ConnectedHumber/Air-Quality-Kit/README.md

# Air-Quality-Kit
Open source documentation and firmware for the CH HumberLora Kit

## Heltec Sensor V2

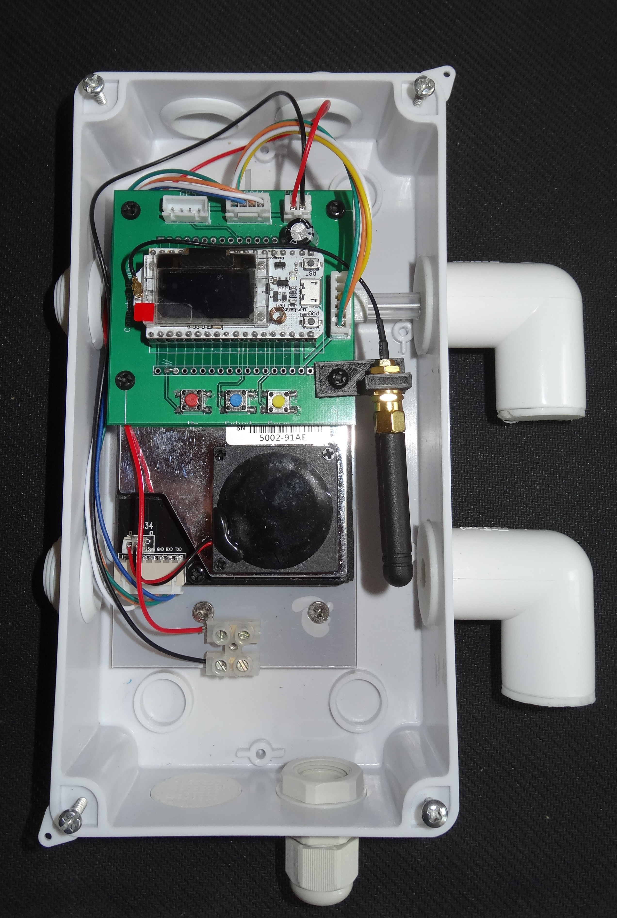
[picture p1: Images/Heltec Sensor V2.jpg]
