ConnectedHumber/Air-Quality-Kit/Documentation/README.md

# Documentation

Documentation explaining the technical details of the CH HumberLora Kit and how to assemble the parts.
