ConnectedHumber/Air-Quality-Kit/PCB Designs/Firebeetle/KiCad/README.md

# Kicad files for the Firebeetle pcb design
