ConnectedHumber/Air-Quality-Kit/Images/AQ_V3_PCB.png

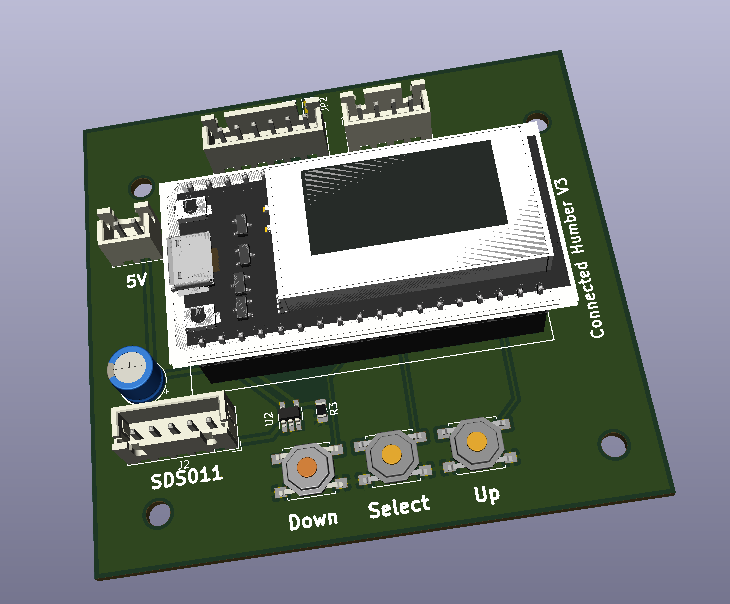
Images/AQ_V3_PCB.png
