ConnectedHumber/Air-Quality-Kit/3D_Parts/Mounting Plate.stl

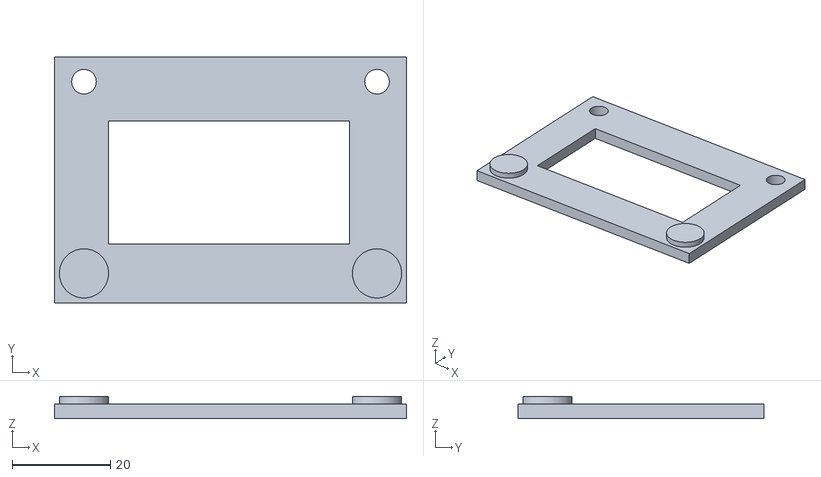
[picture p27: CAD file, 2019-08-29]
3D_Parts/Mounting Plate.stl
71.6 x 50.0 x 4.50
