ConnectedHumber/Air-Quality-Kit/3D_Parts/Drain with Mesh.stl

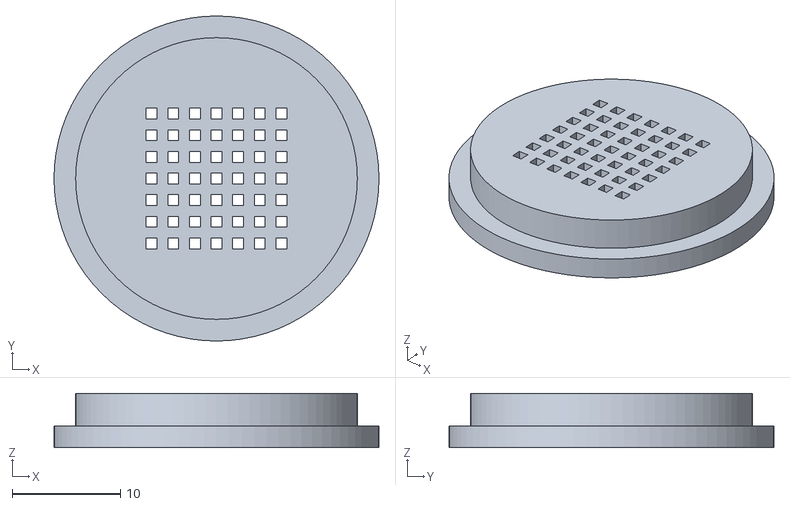
[picture p28: CAD file, 2019-08-27]
3D_Parts/Drain with Mesh.stl
30.0 x 30.0 x 5.00
