ConnectedHumber/Air-Quality-Kit/3D_Parts/Outer Vent Plug with Mesh.stl

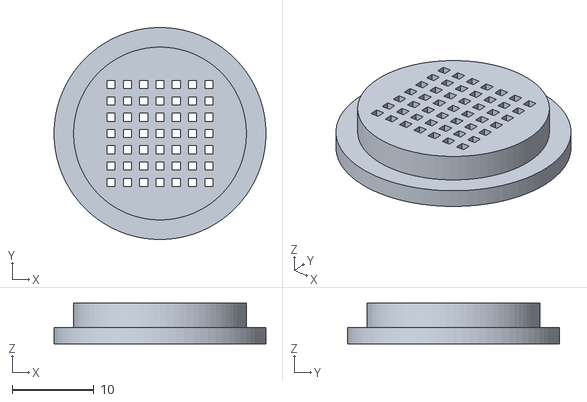
[picture p29: CAD file, 2019-08-27]
3D_Parts/Outer Vent Plug with Mesh.stl
26.0 x 26.0 x 5.00
