ConnectedHumber/Air-Quality-Kit/3D_Parts/Inner Vent Plug.stl

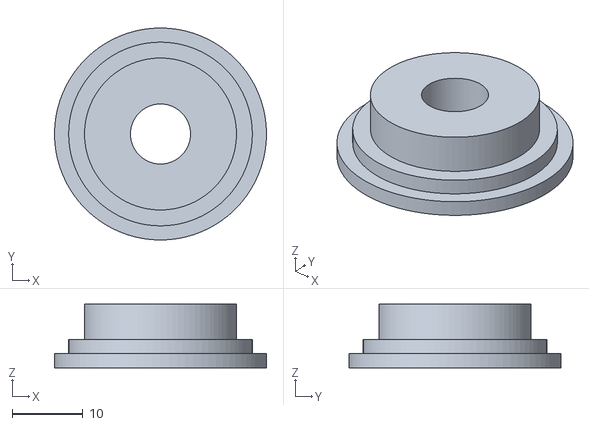
[picture p30: CAD file, 2019-08-25]
3D_Parts/Inner Vent Plug.stl
30.0 x 30.0 x 9.00
