ConnectedHumber/Air-Quality-Kit/3D_Parts/Drain.stl

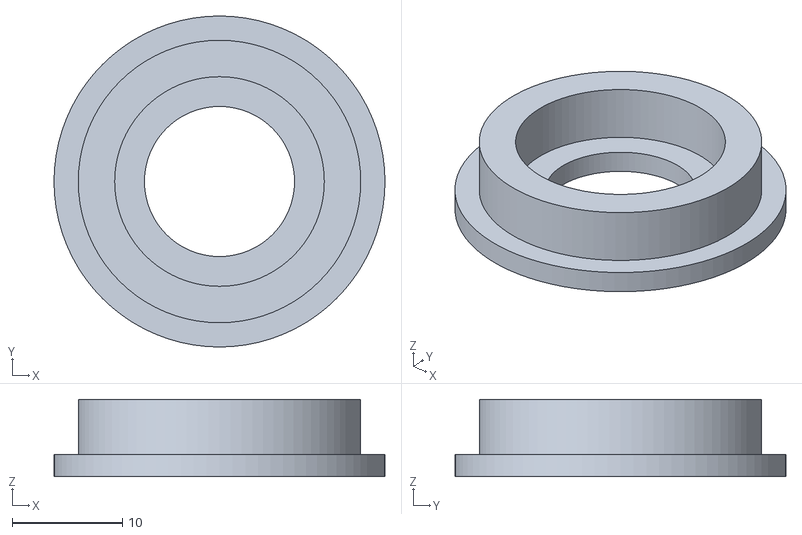
[picture p31: CAD file, 2019-08-25]
3D_Parts/Drain.stl
30.0 x 30.0 x 7.00
