ConnectedHumber/Air-Quality-Kit/3D_Parts/antennaMount.stl

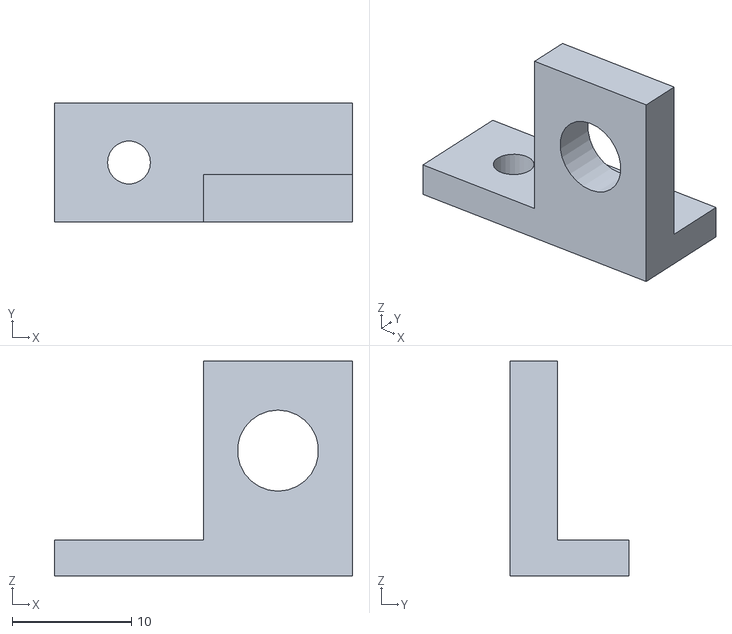
[picture p32: CAD file, 2019-08-25]
3D_Parts/antennaMount.stl
25.0 x 10.0 x 18.0
