ConnectedHumber/Air-Quality-Kit/3D_Parts/SensorLinkingPipe.stl

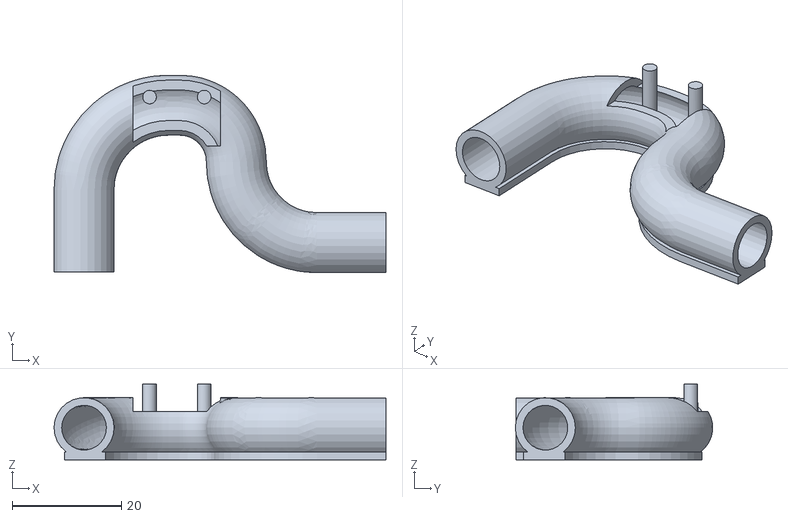
[picture p33: CAD file, 2019-08-25]
3D_Parts/SensorLinkingPipe.stl
60.8 x 36.1 x 13.9
