ConnectedHumber/Air-Quality-Kit/3D_Parts/Outer Vent Plug.stl

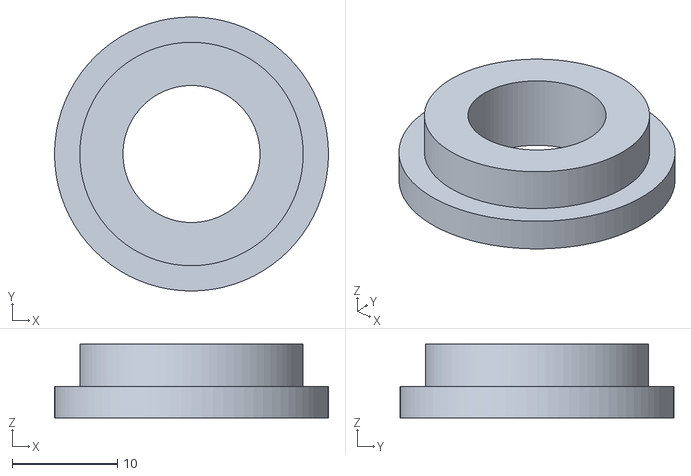
[picture p34: CAD file, 2019-08-25]
3D_Parts/Outer Vent Plug.stl
26.0 x 26.0 x 7.00
