ConnectedHumber/Air-Quality-Kit/3D_Parts/Cable Inlet.stl

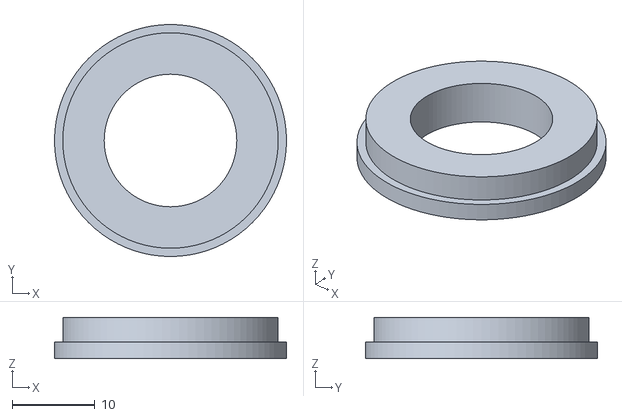
[picture p35: CAD file, 2019-08-25]
3D_Parts/Cable Inlet.stl
28.0 x 28.0 x 5.00
