ConnectedHumber/Air-Quality-Kit/PCB Designs/AQ_V3/Heltec.kicad_pcb

## KiCad design PCB Designs/AQ_V3/Heltec.kicad_pcb (2019-10-04)

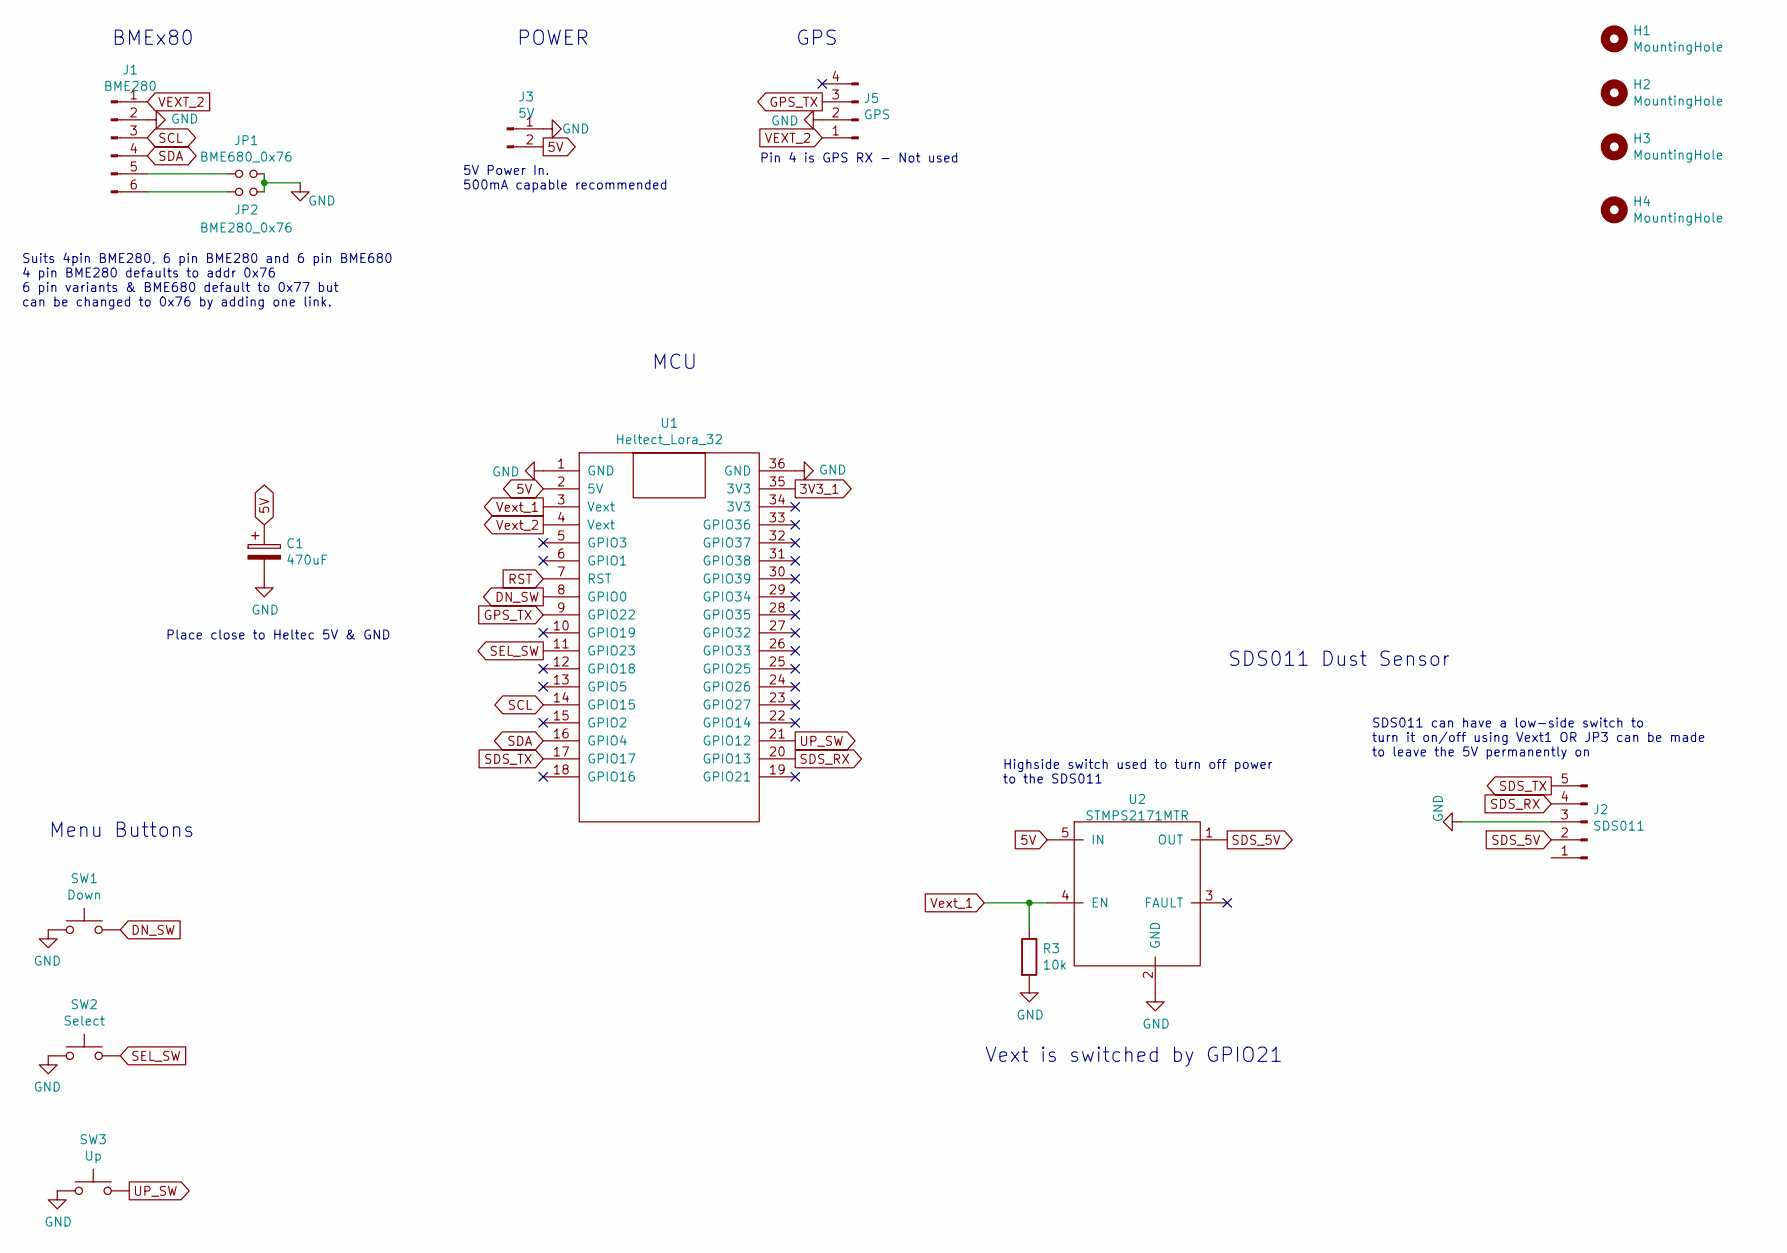
[picture p57: schematic Heltec.sch, Heltec Lora 32 Air Quality]

Parts:
C1: 470uF; CP_Radial_D6.3mm_P2.50mm
H1, H2, H3, H4: MountingHole; MountingHole_3.2mm_M3
J1: BME280; JST_XH_B06B-XH-A_1x06_P2.50mm_Vertical
J2: SDS011; JST_XH_B05B-XH-AM_1x05_P2.50mm_Vertical
J3: 5V; JST_XH_B02B-XH-A_1x02_P2.50mm_Vertical
J5: GPS; JST_XH_B04B-XH-A_1x04_P2.50mm_Vertical
JP1: BME680_0x76; SolderJumper-2_P1.3mm_Open_Pad1.0x1.5mm
JP2: BME280_0x76; SolderJumper-2_P1.3mm_Open_Pad1.0x1.5mm
R3: 10k; R_0805_2012Metric_Pad1.15x1.40mm_HandSolder
SW1: Down; SW_SPST_B3S-1000
SW2: Select; SW_SPST_B3S-1000
SW3: Up; SW_SPST_B3S-1000
U1: Heltect_Lora_32; Heltec_LoRa_32
U2: STMPS2171MTR; SOT-23-5_HandSoldering

Connections:
3V3_1: U1.35 (3V3)
5V: C1.1, J3.2, U1.2 (5V), U2.5 (IN)
DN_SW: SW1.1, U1.8 (GPIO0)
GND: C1.2, J1.2, J2.3, J3.1, J5.2, JP1.2, JP2.2, R3.2, SW1.2, SW2.1, SW3.1, U1.1 (GND), U1.36 (GND), U2.2 (GND)
GPS_TX: J5.3, U1.9 (GPIO22)
unnamed: J1.5, JP1.1
unnamed: J1.6, JP2.1
RST: U1.7 (RST)
SCL: J1.3, U1.14 (GPIO15)
SDA: J1.4, U1.16 (GPIO4)
SDS_5V: J2.2, U2.1 (OUT)
SDS_RX: J2.4, U1.20 (GPIO13)
SDS_TX: J2.5, U1.17 (GPIO17)
SEL_SW: SW2.2, U1.11 (GPIO23)
UP_SW: SW3.2, U1.21 (GPIO12)
VEXT_2: J1.1, J5.1
Vext_1: R3.1, U1.3 (Vext), U2.4 (EN)
Vext_2: U1.4 (Vext)

Notes on the sheet:
Place close to Heltec 5V & GND
Suits 4pin BME280, 6 pin BME280 and 6 pin BME680 4 pin BME280 defaults to addr 0x76 6 pin variants & BME680 default to 0x77 but can be changed to 0x76 by adding one link.
Pin 4 is GPS RX - Not used
SDS011 can have a low-side switch to turn it on/off using Vext1 OR JP3 can be made to leave the 5V permanently on
Highside switch used to turn off power to the SDS011
Menu Buttons
5V Power In. 500mA capable recommended
GPS
POWER
BMEx80
SDS011 Dust Sensor
MCU
Vext is switched by GPIO21

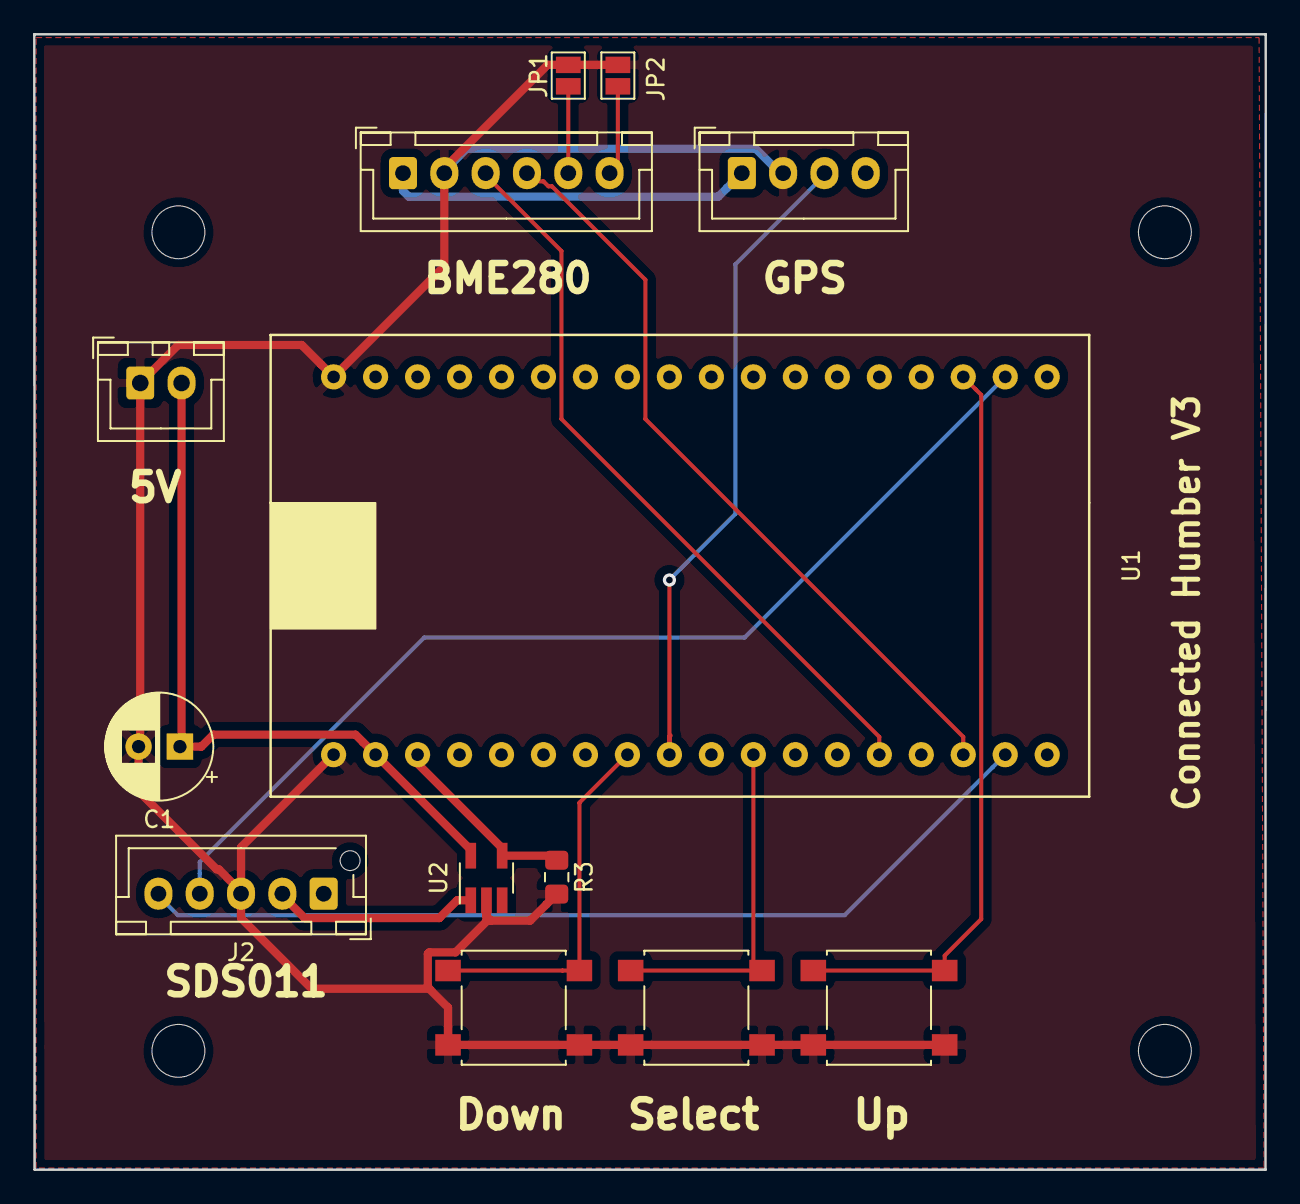
[picture p58: board Heltec.kicad_pcb from above]

Board: 2 copper layers, 74.5 x 68.7 mm, 17 parts (0 on the bottom side), 15 nets.
