ConnectedHumber/Air-Quality-Kit/Firmware/Sources/SensorReaderV3/lcd.cpp

// This example just provide basic function test;
// For more informations, please vist www.heltec.cn or mail to support@heltec.cn

#include "SSD1306.h" // alias for #include "SSD1306Wire.h"`

#include "OLEDDisplayUi.h"
#include "images.h"
#include "timing.h"
#include "settings.h"
#include "sensors.h"
#include "airquality.h"
#include "bme280.h"
#include "debug.h"
#include "lora.h"
#include "mqtt.h"
#include "processes.h"
#include "lcd.h"


//OLED pins to ESP32 GPIOs via this connecthin:
//OLED_SDA -- GPIO4
//OLED_SCL -- GPIO15
//OLED_RST -- GPIO16

struct LcdSettings lcdSettings;

boolean validateSplashScreen(void* dest, const char* newValueStr)
{
	return (validateString((char*)dest, newValueStr, SPLASH_LINE_LENGTH));
}

void setDefaultSplashTopLine(void* dest)
{
	Serial.println("setting default top line");
	snprintf((char*)dest, SPLASH_LINE_LENGTH, "Connected");
}

void setDefaultSplashBottomLine(void* dest)
{
	snprintf((char*)dest, SPLASH_LINE_LENGTH, "Humber");
}

struct SettingItem splash_screen_top_lineSetting = {
"Splash screen top line", "splashTop", lcdSettings.splash_screen_top_line, SPLASH_LINE_LENGTH, text, setDefaultSplashTopLine, validateSplashScreen };

struct SettingItem splash_screen_bottom_lineSetting = {
"Splash screen bottom line", "splashBtm", lcdSettings.splash_screen_bottom_line, SPLASH_LINE_LENGTH, text, setDefaultSplashBottomLine, validateSplashScreen };

struct SettingItem* lcdSettingItemPointers[] =
{
&splash_screen_bottom_lineSetting,
&splash_screen_top_lineSetting };

struct SettingItemCollection lcdSettingItems = {
	"lcd",
	"LCD settings for top and bottom line of home screen",
	lcdSettingItemPointers,
	sizeof(lcdSettingItemPointers) / sizeof(struct SettingItem*)
};


// later version of display constructor nominates a pin for reset which must be added to the
// constructor call

SSD1306 display(0x3c, 4, 15, 16);

OLEDDisplayUi ui(&display);

// from timing.h
unsigned long time_to_next_update();
bool updates_active();

void clockOverlay(OLEDDisplay *display, OLEDDisplayUiState *state)
{
    char time_buffer[100];

    display->setTextAlignment(TEXT_ALIGN_RIGHT);

    if (updates_active())
    {
        int time_to_update_secs = (int)(time_to_next_update() / 1000);

        switch (getTimingState())
        {
        case sensorOff:
            sprintf(time_buffer, "O %04d", time_to_update_secs);
            break;

        case sensorWarmingUp:
            sprintf(time_buffer, "W %04d", time_to_update_secs);
            break;

        case sensorGettingReading:
            sprintf(time_buffer, "R %04d", time_to_update_secs);
            break;
        }
    }

    display->setFont(ArialMT_Plain_10);
    display->drawString(128, 0, time_buffer);
}

void drawSplashScreen(OLEDDisplay *display, OLEDDisplayUiState *state, int16_t x, int16_t y)
{
    display->setTextAlignment(TEXT_ALIGN_CENTER);

    display->setFont(ArialMT_Plain_16);
    display->drawString(64 + x, 10 + y, lcdSettings.splash_screen_top_line);

    display->setFont(ArialMT_Plain_16);
    display->drawString(64 + x, 30 + y, lcdSettings.splash_screen_bottom_line);
}

void drawAirQuality(OLEDDisplay *display, OLEDDisplayUiState *state, int16_t x, int16_t y)
{
    char number_buffer[100];

    display->setTextAlignment(TEXT_ALIGN_LEFT);

    display->setFont(ArialMT_Plain_16);

    airqualityReading *airq = (airqualityReading *)airqSensor.activeReading;

    sprintf(number_buffer, "PM10:  %.1f", airq->pm10);
    display->drawString(0 + x, 10 + y, number_buffer);

    sprintf(number_buffer, "PM25:  %.1f", airq->pm25);
    display->drawString(0 + x, 30 + y, number_buffer);
}

void drawTemp(OLEDDisplay *display, OLEDDisplayUiState *state, int16_t x, int16_t y)
{
    char number_buffer[100];

    bme280Reading *env = (bme280Reading *)bme280Sensor.activeReading;

    display->setTextAlignment(TEXT_ALIGN_LEFT);

    display->setFont(ArialMT_Plain_16);
    sprintf(number_buffer, "Temp:  %.1f", env->temperature);
    display->drawString(0 + x, 0 + y, number_buffer);

    sprintf(number_buffer, "Pressure:  %.1f", env->pressure);
    display->drawString(0 + x, 18 + y, number_buffer);

    sprintf(number_buffer, "Humidity:  %.1f", env->humidity);
    display->drawString(0 + x, 36 + y, number_buffer);
}

void drawDiagnostics(OLEDDisplay *display, OLEDDisplayUiState *state, int16_t x, int16_t y)
{
    char status_buffer[100];

    display->setTextAlignment(TEXT_ALIGN_LEFT);

    display->setFont(ArialMT_Plain_10);

    WiFiProcessDescriptor.getStatusMessage(&WiFiProcessDescriptor, status_buffer,100);

    display->drawString(0 + x, 0 + y, status_buffer);

    MQTTProcessDescriptor.getStatusMessage(&MQTTProcessDescriptor, status_buffer,100);

    display->drawString(0 + x, 10 + y, status_buffer);

    if (loRaSettings.loraOn)
        sprintf(status_buffer, "LoRa sent: %d", getLoraSentCount());
    else
    {
        sprintf(status_buffer, "LoRa Off");
    }

    display->drawString(0 + x, 20 + y, status_buffer);

    sprintf(status_buffer, "MQTT gap: %d", mqttSettings.mqttSecsPerUpdate);

    display->drawString(0 + x, 30 + y, status_buffer);

    sprintf(status_buffer, "LoRa gap: %d", loRaSettings.seconds_per_lora_update);

    display->drawString(0 + x, 40 + y, status_buffer);
}

#define MAX_LINE_LENGTH 40
#define MAX_LINE_LIMIT MAX_LINE_LENGTH - 1
#define NO_OF_LINES 5

char active_menu[NO_OF_LINES][MAX_LINE_LENGTH];

uint8_t active_menu_item = 0;
uint8_t no_of_menu_items = 0;

void drawMenuFrame(OLEDDisplay *display, OLEDDisplayUiState *state, int16_t x, int16_t y)
{

    uint8_t lineHeight = 12;
    uint8_t linePos = 0;
    display->setTextAlignment(TEXT_ALIGN_LEFT);

    display->setFont(ArialMT_Plain_16);

    for (int i = 0; i < no_of_menu_items; i++)
    {
        if (i == active_menu_item)
        {
            display->drawString(0 + x, linePos + y, "=>");
        }
        display->drawString(20 + x, linePos + y, active_menu[i]);
        linePos += lineHeight;
    }
}

void build_menu(String menu_text)
{
    uint8_t line_count = 0;
    uint8_t line_pos = 0;
    uint8_t input_pos = 0;
    while (true)
    {
        if (menu_text[input_pos] == '\n')
        {
            // terminate the current string
            active_menu[line_count][line_pos] = 0;
            // Skip past the line feed
            input_pos++;
            // move on to the next line
            line_count++;
            line_pos = 0;
            if (line_count == NO_OF_LINES)
                break;
        }

        if (menu_text[input_pos] == 0)
        {
            // terminate the current string
            active_menu[line_count][line_pos] = 0;
            line_count++;
            break;
        }

        if (line_pos == MAX_LINE_LIMIT)
        {
            // line to long for display - truncate - spin to end of line
            while (menu_text[input_pos] != 0 && menu_text[input_pos] != '\n')
                input_pos++;
            break;
        }

        active_menu[line_count][line_pos] = menu_text[input_pos];
        input_pos++;
        line_pos++;
    }
    no_of_menu_items = line_count;
}

// This array keeps function pointers to all frames
// frames are the single views that slide in

FrameCallback workingFrames[] = {drawSplashScreen, drawAirQuality, drawTemp, drawDiagnostics};
FrameCallback workingFramesNoSplash[] = {drawAirQuality, drawTemp, drawDiagnostics};

// how many frames are there?
int workingFrameCount = 4;

// Overlays are statically drawn on top of a frame eg. a clock
OverlayCallback workingOverlays[] = {clockOverlay};
int workingOverlaysCount = 1;

void setWorkingDisplay()
{
    // Customize the active and inactive symbol
    ui.setActiveSymbol(activeSymbol);
    ui.setInactiveSymbol(inactiveSymbol);

    ui.enableAllIndicators();
    // You can change this to
    // TOP, LEFT, BOTTOM, RIGHT
    ui.setIndicatorPosition(BOTTOM);

    // Defines where the first frame is located in the bar.
    ui.setIndicatorDirection(LEFT_RIGHT);

    // You can change the transition that is used
    // SLIDE_LEFT, SLIDE_RIGHT, SLIDE_UP, SLIDE_DOWN
    ui.setFrameAnimation(SLIDE_LEFT);

    // Add frames
    if ((lcdSettings.splash_screen_bottom_line[0] == 0) && (lcdSettings.splash_screen_top_line[0] == 0))
    {
        // If the splash screen text is empty - don't display the splash screen
        ui.setFrames(workingFramesNoSplash, workingFrameCount - 1);
    }
    else
    {
        ui.setFrames(workingFrames, workingFrameCount);
    }

    // Add overlays
    ui.setOverlays(workingOverlays, workingOverlaysCount);

    ui.enableAutoTransition();
}

String message_display_text;
String message_display_title;

void drawMessageFrame(OLEDDisplay *display, OLEDDisplayUiState *state, int16_t x, int16_t y)
{
    display->setTextAlignment(TEXT_ALIGN_CENTER);

    display->setFont(ArialMT_Plain_16);
    display->drawString(64 + x, 0 + y, message_display_title);

    display->setFont(ArialMT_Plain_16);
    display->drawStringMaxWidth(64 + x, 20 + y, 128, message_display_text);
}

FrameCallback messageFrames[] = {drawMessageFrame};

// how many frames are there?
int messageFrameCount = 1;

// Overlays are statically drawn on top of a frame eg. a clock
OverlayCallback messageOverlays[] = {clockOverlay};
int messageOverlayCount = 0;

void activate_message_display()
{
    TRACELN("Set message display");

    ui.disableAllIndicators();
    ui.disableAutoTransition();

    // Add frames
    ui.setFrames(messageFrames, messageFrameCount);

    // Add overlays
    ui.setOverlays(messageOverlays, messageOverlayCount);
}

void set_message_display(String title, String text)
{
    TRACELN("Set message display");
    message_display_title = title;
    message_display_text = text;

    activate_message_display();
}

String action_display_text;
String action_display_title;

void drawActionFrame(OLEDDisplay *display, OLEDDisplayUiState *state, int16_t x, int16_t y)
{
    display->setTextAlignment(TEXT_ALIGN_CENTER);

    display->setFont(ArialMT_Plain_16);
    display->drawString(64 + x, 0 + y, action_display_title);

    display->setFont(ArialMT_Plain_16);
    display->drawStringMaxWidth(64 + x, 20 + y, 128, action_display_text);
}

FrameCallback actionFrames[] = {drawActionFrame};

// how many frames are there?
int actionFrameCount = 1;

// Overlays are statically drawn on top of a frame eg. a clock
OverlayCallback actionOverlays[] = {clockOverlay};
int actionOverlayCount = 0;

void activate_action_display()
{
    ui.disableAllIndicators();
    ui.disableAutoTransition();

    // Add frames
    ui.setFrames(actionFrames, actionFrameCount);

    // Add overlays
    ui.setOverlays(actionOverlays, actionOverlayCount);
}

void setPopupMessage(String title, String text)
{
    TRACELN("Set message display");
    action_display_title = title;
    action_display_text = text;

    activate_action_display();
}

int display_number_being_input;
String number_input_prompt;

void drawNumberInputFrame(OLEDDisplay *display, OLEDDisplayUiState *state, int16_t x, int16_t y)
{

    display->setTextAlignment(TEXT_ALIGN_CENTER);

    display->setFont(ArialMT_Plain_16);
    display->drawString(64 + x, 0 + y, number_input_prompt);

    display->setFont(ArialMT_Plain_16);
    char buffer[20];
    sprintf(buffer, "%d", display_number_being_input);

    display->drawString(64 + x, 40 + y, buffer);
}

void set_display_number_being_input(int new_value)
{
    display_number_being_input = new_value;
}

FrameCallback numberInputFrames[] = {drawNumberInputFrame};

// how many frames are there?
int numberInputFrameCount = 1;

// Overlays are statically drawn on top of a frame eg. a clock
OverlayCallback numberInputOverlays[] = {clockOverlay};
int numberInputOverlayCount = 0;

void activate_number_input_display()
{
    ui.disableAllIndicators();
    ui.disableAutoTransition();

    // Add frames
    ui.setFrames(numberInputFrames, numberInputFrameCount);

    // Add overlays
    ui.setOverlays(numberInputOverlays, numberInputOverlayCount);
}

void set_number_input_display(String in_number_input_prompt, int in_number_being_input)
{
    TRACELN("Set number input display");
    number_input_prompt = in_number_input_prompt;
    display_number_being_input = in_number_being_input;
    activate_number_input_display();
}

String currentStringSelection;
String stringSelectionPrompt;

void drawStringSelectionFrame(OLEDDisplay *display, OLEDDisplayUiState *state, int16_t x, int16_t y)
{

    display->setTextAlignment(TEXT_ALIGN_CENTER);

    display->setFont(ArialMT_Plain_16);
    display->drawString(64 + x, 0 + y, stringSelectionPrompt);
    display->drawString(64 + x, 30 + y, currentStringSelection);
}

void setStringSelection(String newValue)
{
    currentStringSelection = newValue;
}

FrameCallback stringSelectionFrames[] = {drawStringSelectionFrame};

// how many frames are there?
int stringSelectionFrameCount = 1;

// Overlays are statically drawn on top of a frame eg. a clock
OverlayCallback stringSelectionOverlays[] = {clockOverlay};
int stringSelectionOverlayCount = 0;

void activeStringSelectionDisplay()
{
    ui.disableAllIndicators();
    ui.disableAutoTransition();

    // Add frames
    ui.setFrames(stringSelectionFrames, stringSelectionFrameCount);

    // Add overlays
    ui.setOverlays(stringSelectionOverlays, stringSelectionOverlayCount);
}

void setStringSelectionDisplay(String inStringSelectionPrompt, String inCurrentStringSelection)
{
    TRACELN("Set number input display");
    currentStringSelection = inCurrentStringSelection;
    stringSelectionPrompt = inStringSelectionPrompt;
    activeStringSelectionDisplay();
}

FrameCallback menuFrames[] = {drawMenuFrame};

// how many frames are there?
int menuFrameCount = 1;

// Overlays are statically drawn on top of a frame eg. a clock
OverlayCallback menuOverlays[] = {clockOverlay};
int menuOverlayCount = 0;

// Used to connect the menu to the LCD

// Displays the menu text and sets the cursor positon to the given
// item.

void setMenuDisplay(String menu_text, uint64_t pos_in_menu)
{
    build_menu(menu_text);
    active_menu_item = pos_in_menu;

    ui.disableAllIndicators();
    ui.disableAutoTransition();

    // Add frames
    ui.setFrames(menuFrames, menuFrameCount);

    // Add overlays
    ui.setOverlays(menuOverlays, menuOverlayCount);
}

void move_selector_up()
{
    TRACELN("Moving up");
    if (active_menu_item == 0)
    {
        TRACELN("Up wrapping");
        active_menu_item = no_of_menu_items - 1;
    }
    else
        active_menu_item--;
}

void move_selector_down()
{
    TRACELN("Moving down");
    active_menu_item++;

    if (active_menu_item == no_of_menu_items)
    {
        TRACELN("Down wrapping");
        active_menu_item = 0;
    }
}

int getSelectedItem()
{
    return active_menu_item;
}

bool set_selected_item(int item)
{
    if (item < 0)
        return false;

    if (item >= no_of_menu_items)
        return false;

    active_menu_item = item;

    return true;
}

void lcdSleep()
{
    display.sleep();
}

void lcdWake()
{
	display.init();
	display.wakeup();
}

void drawClearFrame(OLEDDisplay *display, OLEDDisplayUiState *state, int16_t x, int16_t y)
{
}

FrameCallback clearFrames[] = {drawClearFrame};

int clearFrameCount = 1;

OverlayCallback clearOverlays[] = {clockOverlay};

int clearOverlayCount = 0;

//at the moment the cleared frame shows nothing
void setClearDisplayPage()
{
    ui.disableAllIndicators();
    ui.disableAutoTransition();

    // Add frames
    ui.setFrames(clearFrames, clearFrameCount);

    // Add overlays
    ui.setOverlays(clearOverlays, clearOverlayCount);
}

int startLCD(struct process * lcdProcess)
{
    TRACELN("Setting up LCD");

    // The ESP is capable of rendering 60fps in 80Mhz mode
    // but that won't give you much time for anything else
    // run it in 160Mhz mode or just set it to 30 fps

    //ui.setTargetFPS(60);

    setWorkingDisplay();

    
    // Initialising the UI will init the display too.
    ui.init();

    display.flipScreenVertically();

	return PROCESS_OK;
}

bool first_time_lcd_loop = true;

int updateLCD(struct process * lcdProcess)
{
    if (first_time_lcd_loop)
    {
        setWorkingDisplay();
        first_time_lcd_loop = false;
    }

    int remainingTimeBudget = ui.update();

    if (remainingTimeBudget > 0)
    {
        // You can do some work here
        // Don't do stuff if you are below your
        // time budget.
        delay(remainingTimeBudget);
    }
	return PROCESS_OK;
}

int stopLCD(struct process * lcdProcess)
{
	lcdSleep();

	return PROCESS_OK;
}

void LCDStatusMessage(struct process * timingProcess, char * buffer, int bufferLength)
{
    snprintf(buffer, bufferLength, "LCD OK");
}
