ConnectedHumber/Air-Quality-Kit/Firmware/Sources/NewBoard/inputswitch.cpp

#include <Arduino.h>

#include "utils.h"
#include "inputswitch.h"
#include "settings.h"

struct InputSwitchSettings inputSwitchSettings;

void setDefaultControlInputPin(void* dest)
{
	int* destInt = (int*)dest;
	*destInt = 25;
}

struct SettingItem controlInputPinSetting = {
		"Control Input Pin",
		"controlinputpin",
		& inputSwitchSettings.controlInputPin,
		NUMBER_INPUT_LENGTH,
		integerValue,
		setDefaultControlInputPin,
		validateInt };

struct SettingItem controlInputPinActiveLowSetting = {
		"Control Input Active Low",
		"controlinputlow",
		& inputSwitchSettings.controlInputPinActiveLow,
		ONOFF_INPUT_LENGTH,
		yesNo,
		setTrue,
		validateYesNo
};

struct SettingItem* inputSwitchSettingItemPointers[] =
{
&controlInputPinSetting,
&controlInputPinActiveLowSetting
};

struct SettingItemCollection inputSwitchSettingItems = {
	"inputswitch",
	"Pin assignment and level (high or low) for hardware configuration switch",
	inputSwitchSettingItemPointers,
	sizeof(inputSwitchSettingItemPointers) / sizeof(struct SettingItem*)
};




int lastInputValue;
long inputDebounceStartTime;

boolean switchValue;

boolean getInputSwitchValue()
{
	return switchValue;
}

unsigned long millisAtLastInputChange;

// number of milliseconds that the signal must be stable
// before we read it

#define INPUT_DEBOUNCE_TIME 10


int startInputSwitch(struct process * inputSwitchProcess)
{
	pinMode(inputSwitchSettings.controlInputPin, INPUT_PULLUP);
	return PROCESS_OK;
}

int updateInputSwitch(struct process * inputSwitchProcess)
{
	int newInputValue = digitalRead(inputSwitchSettings.controlInputPin);

	if (newInputValue == lastInputValue)
	{
		inputDebounceStartTime = offsetMillis();
	}
	else
	{
		//Serial.println("button change");
		long currentMillis = offsetMillis();
		long millisSinceChange = ulongDiff(currentMillis, inputDebounceStartTime);

		if (++millisSinceChange > INPUT_DEBOUNCE_TIME)
		{
			//Serial.println("setting");
			if (newInputValue)
			{
				// input is now high
				if(inputSwitchSettings.controlInputPinActiveLow)
				{
					switchValue = false;
					//Serial.println("active low going false");
				}
				else
				{
					switchValue = true;
					//Serial.println("active high going true");
				}
			}
			else
			{
				// input is now low
				if(inputSwitchSettings.controlInputPinActiveLow)
				{
					switchValue = true;
					//Serial.println("active low going true");
				}
				else
				{
					switchValue = false;
					//Serial.println("active high going false");
				}
			}
			lastInputValue = newInputValue;
		}
	}
	return PROCESS_OK;
}

int stopInputSwitch(struct process * inputSwitchProcess)
{
	return INPUT_SWITCH_STOPPED;
}

void inputSwitchStatusMessage(struct process * inputSwitchProcess, char * buffer, int bufferLength)
{
	if (switchValue)
		snprintf(buffer, bufferLength, "Input switch pressed");
	else
		snprintf(buffer, bufferLength, "Input switch released");
}


boolean readInputSwitch()
{

	pinMode(inputSwitchSettings.controlInputPin, INPUT_PULLUP);

	int newInputValue;
	int lastInputValue = digitalRead(inputSwitchSettings.controlInputPin);
	long inputDebounceStartTime = offsetMillis();

	while (true)
	{
		int newInputValue = digitalRead(inputSwitchSettings.controlInputPin);

		if (newInputValue != lastInputValue)
		{
			inputDebounceStartTime = offsetMillis();
			lastInputValue = newInputValue;
		}
		else
		{
			long currentMillis = offsetMillis();
			long millisSinceChange = ulongDiff(currentMillis, inputDebounceStartTime);

			if (++millisSinceChange > INPUT_DEBOUNCE_TIME)
			{
				if (newInputValue)
					return !inputSwitchSettings.controlInputPinActiveLow;
				else
					return inputSwitchSettings.controlInputPinActiveLow;
			}
		}
		delay(1);
	}
}
