ConnectedHumber/Air-Quality-Kit/Firmware/Sources/SensorReaderV3/lcd.h

#ifndef LCD_H

#define LCD_H

#define SPLASH_LINE_LENGTH 15

struct LcdSettings {
	char splash_screen_top_line[SPLASH_LINE_LENGTH];
	char splash_screen_bottom_line[SPLASH_LINE_LENGTH];
};

extern struct LcdSettings lcdSettings;

extern struct SettingItemCollection lcdSettingItems;

void setWorkingDisplay();
void set_message_display(String title, String text);
void setPopupMessage(String title, String text);
void set_display_number_being_input(int new_value);
void activate_number_input_display();
void set_number_input_display(String in_number_input_prompt, int in_number_being_input);
void setStringSelection(String newValue);
void activeStringSelectionDisplay();
void setStringSelectionDisplay(String inStringSelectionPrompt, String inCurrentStringSelection);
void setMenuDisplay(String menu_text, uint64_t pos_in_menu);
void move_selector_up();
void move_selector_down();
int getSelectedItem();
bool set_selected_item(int item);
void setClearDisplayPage();

int startLCD(struct process * lcdProcess);

int updateLCD(struct process * lcdProcess);

int stopLCD(struct process * lcdProcess);

void LCDStatusMessage(struct process * timingProcess, char * buffer, int bufferLength);

void activate_message_display();
void activate_action_display();

void lcdSleep();
void lcdWake();

#endif
