ConnectedHumber/Air-Quality-Kit/Firmware/Sources/NewBoard/configwifi.h

#ifndef CONFIG_WIFI_H

#define CONFIG_WIFI_H

#include "processes.h"

int startWifiConfig(struct process * wifiConfigProcess);
int updateWifiConfig(struct process * wifiConfigProcess);
int stopWifiConfig(struct process * wifiConfigProcess);
void wifiConfigStatusMessage(struct process * wifiConfigProcess, char * buffer, int bufferLength);

#endif // !CONFIG_WIFI_H
