ConnectedHumber/Air-Quality-Kit/Firmware/Sources/SensorReaderV3/inputkeys.h

#ifndef INPUTKEYS_H

#define INPUTKEYS_H

int startInputKeys(struct process * timingProcess);

int updateInputKeys(struct process * timingProcess);

int stopInputKeys(struct process * timingProcess);

void inputKeysStatusMessage(struct process * timingProcess, char * buffer, int bufferLength);

boolean bindKeyDownHandler(char * keyName, void(*handler)());

boolean bindKeyUpHandler(char * keyName, void(*handler)());

#endif
