ConnectedHumber/Air-Quality-Kit/Firmware/Sources/NewBoard/utils.h

#ifndef UTILS_H

#define UTILS_H

int srtcasecmp(const char *string1, const char *string2);

unsigned long ulongDiff(unsigned long end, unsigned long start);

// typenames to match the LoRa library

typedef uint8_t            bit_t;
typedef uint8_t            u1_t;
typedef int8_t             s1_t;
typedef uint16_t           u2_t;
typedef int16_t            s2_t;
typedef uint32_t           u4_t;
typedef int32_t            s4_t;
typedef unsigned int       uint;

#endif // !UTILS_H
