ConnectedHumber/Air-Quality-Kit/(commit log)

2019-08-27 Added built in filter to the plugs
    reduces BOM.
    [Drain with Mesh.stl, Outer Vent Plug with Mesh.stl]
2019-08-29 Added enclosure mounting plate
    The plate is glued to the back of the enclosure therefore not requiring the enclosure to be drilled and so compromise its integrity.
2019-08-29 Plate to glue to back of enclosure for mounting
    Reduces risk of water ingress if used.
    [Mounting Plate.stl]
2019-08-29 Device Assembly
    Series of slides showing how to create the Connected Humber air monitoring device.
2019-09-09 BME280 and MQTT Fixes
    Added handling of secure sockets on MQTT port 8883. Improved BME280 to allow multiple I2C addresses .
    [bme280.h, mqtt.h]
2019-09-23 Heltec Sensor V2
2019-09-23 V3 PCB
2019-09-23 Added image of Heltec Sensor V2
2019-10-26 Explanation of JP1 and JP2 jumpers and PCB layout
2019-10-31 Fixed popup and sensor startup bugs
    [timing.h]
2019-11-03 First Migration of Top Hat code to ESP32
2019-11-09 Fixed MQTT messages
    Fixed MQTT message format
    [configwifi.cpp, errors.h, settings.cpp]
2019-11-12 Added 3x10mm screw to secure antenna mounting and tidy up
2019-11-12 Added fixed popup messages
    [configwifi.cpp, lora.cpp, menu.cpp, menu.h, processes.cpp, timing.cpp, utils.h]
2019-11-17 Power switch tests
2019-11-17 Work in progress migrating settings into processors and sensors
2020-01-09 First new sensor board releaed
2020-01-10 Lora device started working
2020-01-17 Working newboard
    Working new board code. Uses deep sleep between readings. Also disables brownout detector during power on of the 5V inverter.
    [airquality.cpp, bme280.cpp, clock.cpp, connectwifi.cpp, gps.cpp, inputswitch.cpp, lora.cpp, lora.h]
2020-02-02 Working version
    Version prior to the addition of status flashing lights and WiFi failure management.
    [bme280.cpp, connectwifi.cpp, powercontrol.cpp, timing.cpp]
2020-02-02 Low Power Upgrade
    Added a messaging system and timeouts and shutdowns for WiFi and MQTT.
2020-02-05 It's a lot better now
    • Added stop methods to sensors.h, all the sensor drivers (airq, gps, bme280, clock) and modified sensors.c to connect them.
    • Updated the start and stop methods to improve the appearance of the display
    • added code to the BME280 to make it use the fitted value in settings
    • added settings for BME280 power pin and power control. Added code to use them in sensor startup and stop. This was a stupid idea. Power control should go in the power module.
    • Noticed that the BME280 initialise code seems to run OK when the sensor is not connected. If there is a BME280 connected it will give a "phantom response" when reset but return nan values. Can use isnan(x) to test i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
    [NewBoard.ino, airquality.cpp, airquality.h, bme280.cpp, bme280.h, clock.cpp, clock.h, connectwifi.cpp]
2020-02-05 Proper Power Management
    • removed the power settings from powercontrol and put them back into BME280 and particle sensor
    • converted powercontrol from a process into a library
    • create a structure that defines a switched power pin and added instances to BME280 and particle sensor. Added routines to manage the power pin.
    • Added a brownout detection specifier so that a pin can be controlled without causing brownouts.
    • Moved minimumPowerOffIntervalSecs into timing.c
    • added power pin particle sensor status management into the particle sensor code. Timing routines now just have to turn off the power and the particle sensor does the right thing.
    [airquality.cpp, airquality.h, bme280.cpp, bme280.h, powercontrol.cpp, powercontrol.h, processes.cpp, timing.cpp]
2020-02-05 Nearly ready for release
    • Added handing of the LoRa settings to the web page
    • Tidied up the web page display and made the settings titles consistent
2020-02-06 Improved MQTT command management
    • fixed a bug whereby only the latest reading and not the average environmental values are sent in an MQTT reading. Fixed it.
    • changed the handling of timeout so that an incomplete reading is sent rather than just skipping a reading
    • Bug in modification so that the air quality reading was not sent when only the environmental sensor was disabled. This is because the reading age was less than the reading timeout. So a reading taken at the start of the reading period would be "out of date" by the time that the reading had timed out. Fix this by increasing the reading age to 60 seconds. Also modified the reading timeout setting so this cannot be set more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
    [airquality.cpp, airquality.h, bme280.cpp, bme280.h, mqtt.cpp, settings.cpp]
